omron93/fire-pi/P1200535.JPG

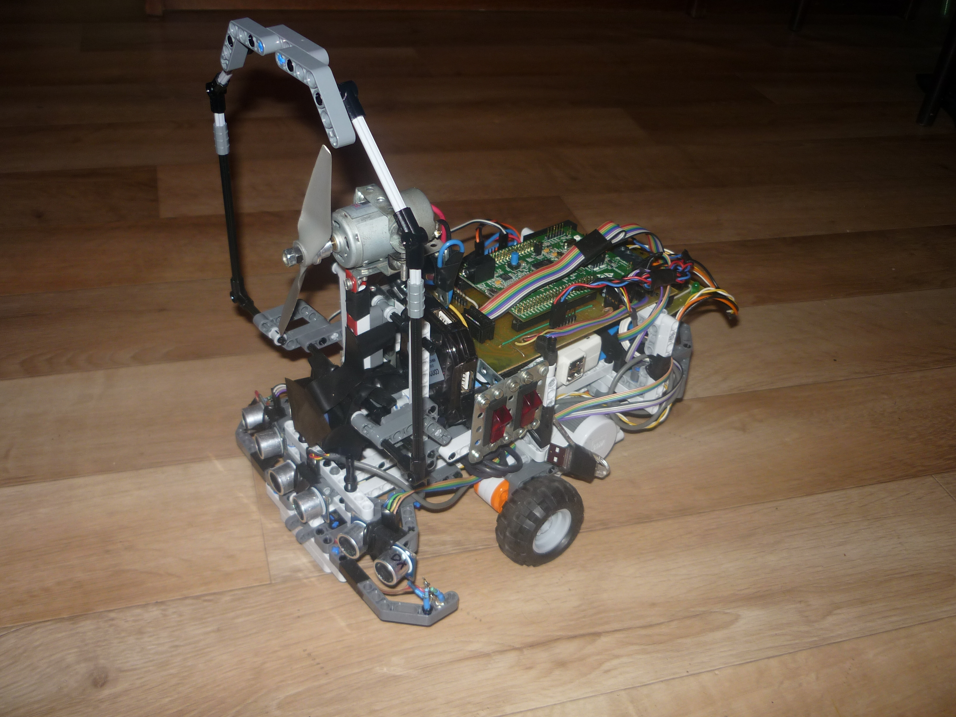
P1200535.JPG
