omron93/fire-pi/DPS/main_board_low.png

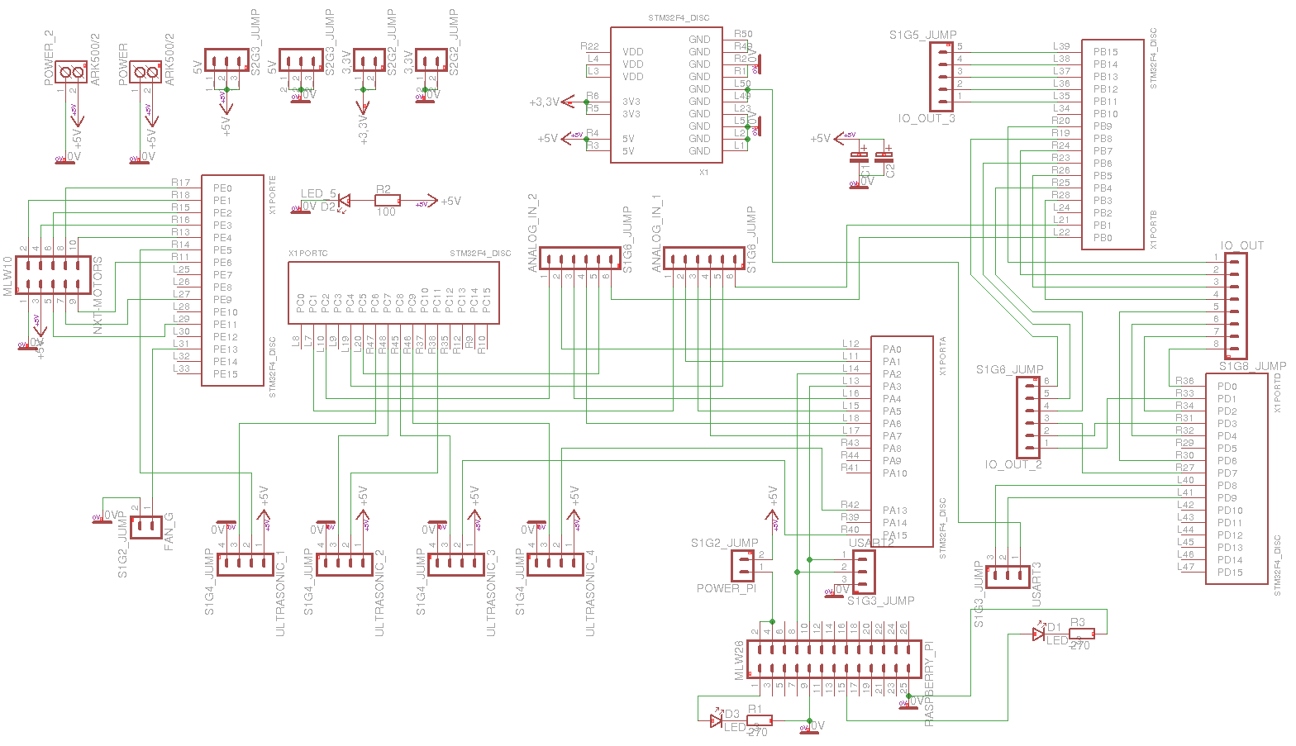
DPS/main_board_low.png
