omron93/fire-pi/DPS/Motor_NXT_Board/1.png

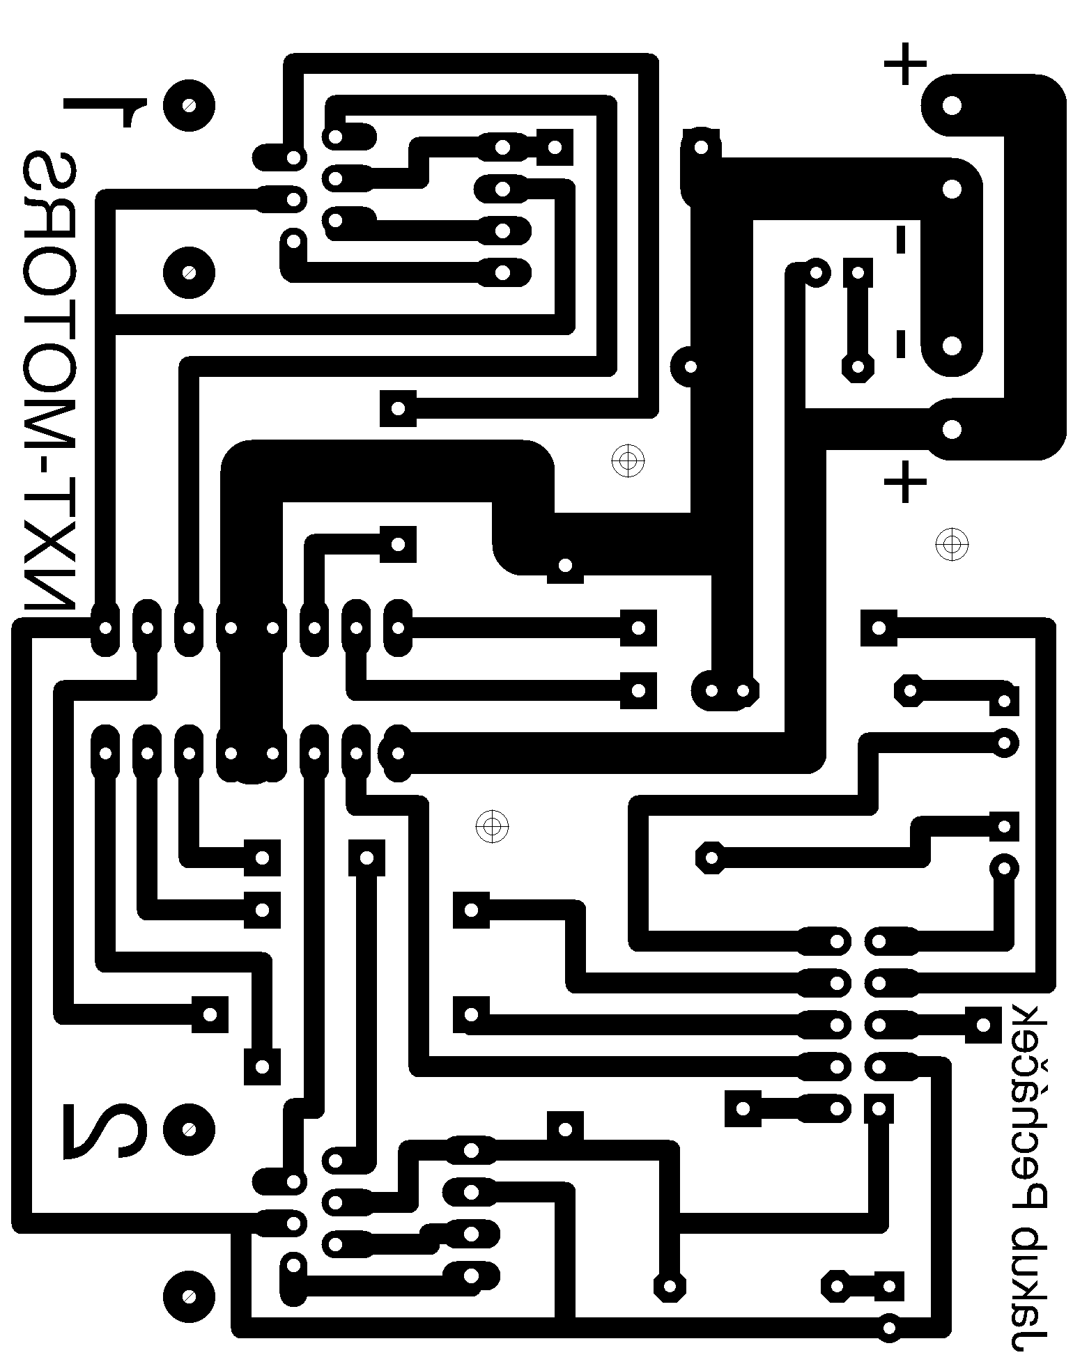
DPS/Motor_NXT_Board/1.png
