omron93/fire-pi/Raspberry_Pi/Candle detector/candle.png

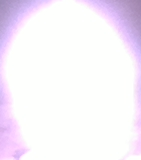
Raspberry_Pi/Candle detector/candle.png
