omron93/fire-pi/DPS/Main_Board/STM.pdf

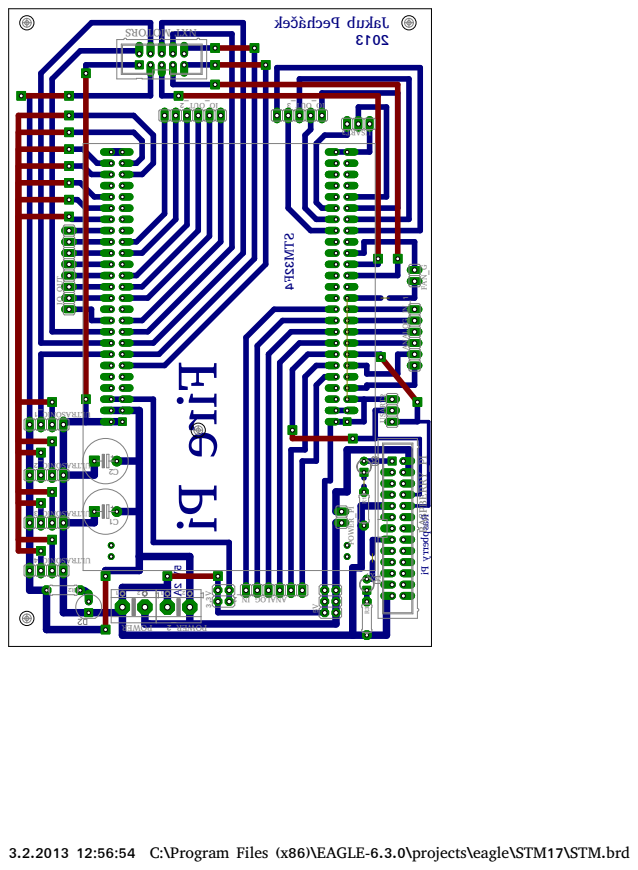
[picture p22: page 1]

3.2.2013 12:56:54 C:\Program Files (x86)\EAGLE-6.3.0\projects\eagle\STM17\STM.brd
