omron93/fire-pi/DPS/Main_Board/STM_brd.pdf

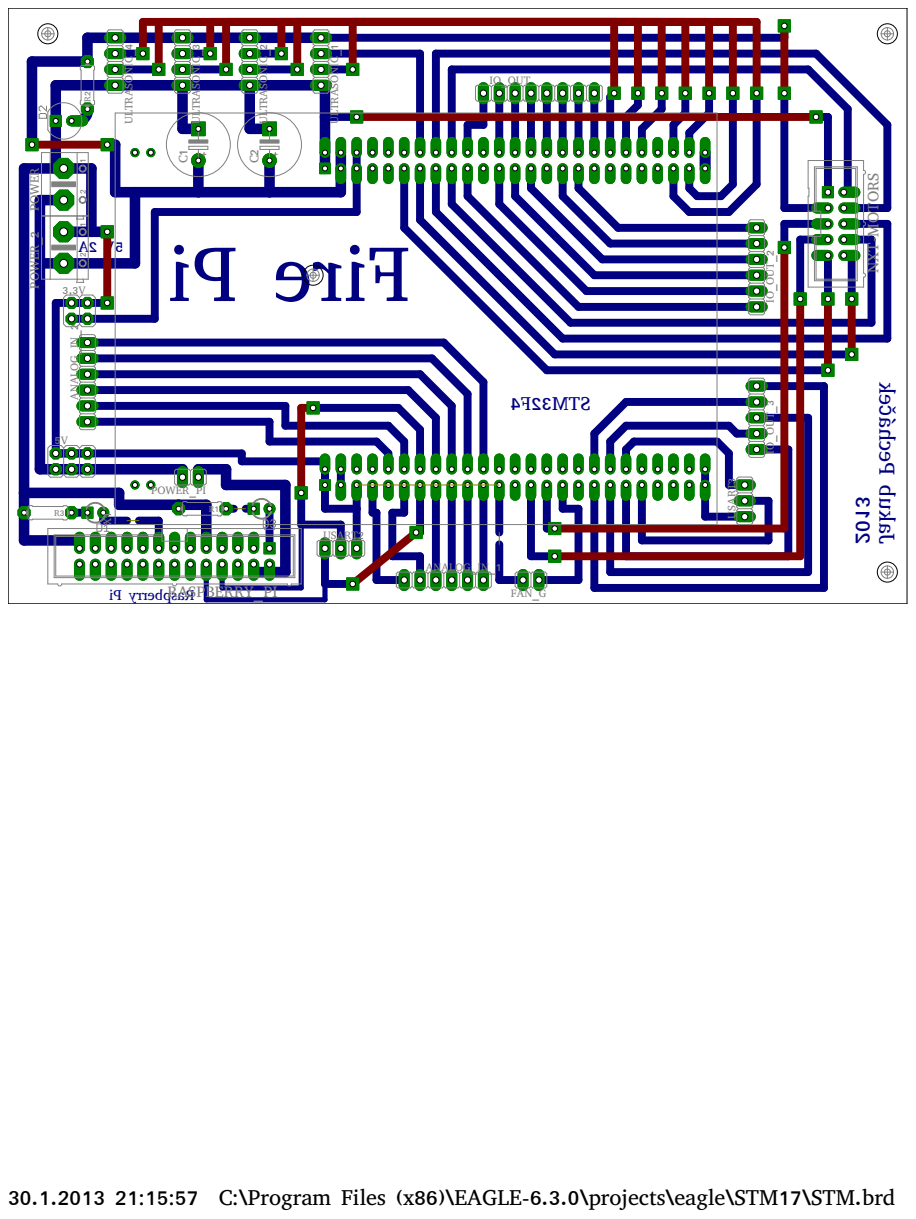
[picture p23: page 1]

30.1.2013 21:15:57 C:\Program Files (x86)\EAGLE-6.3.0\projects\eagle\STM17\STM.brd
