omron93/fire-pi/DPS/Main_Board/STM.brd

## EAGLE design DPS/Main_Board/STM.brd (2014-01-21)

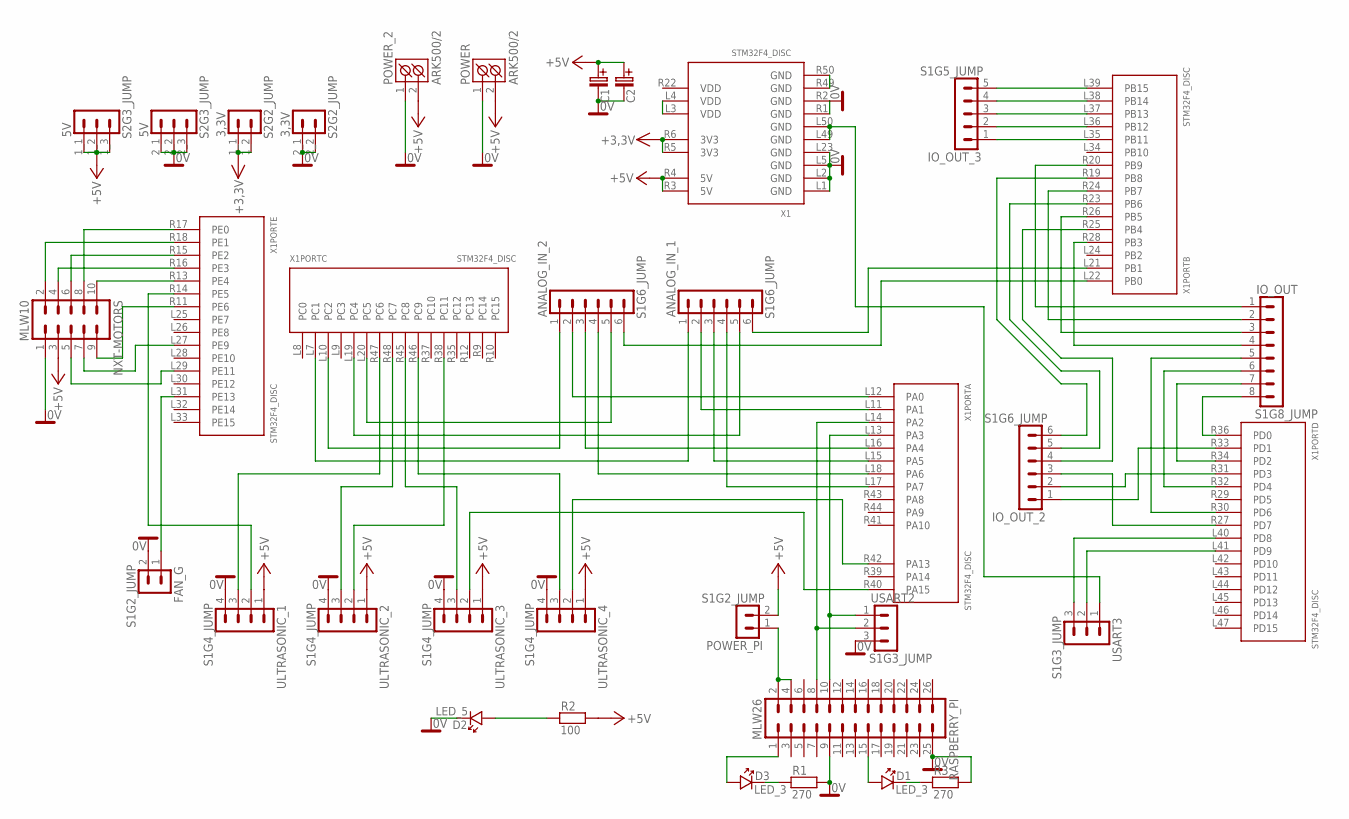
[picture p24: schematic STM.sch]

Parts:
3,3V: S2G2_JUMP; S2G2_JUM
5V: S2G3_JUMP; S2G3_JUM
ANALOG_IN_1, ANALOG_IN_2: S1G6_JUMP; S1G6_JUM
C1, C2: #_RADIAL_POUZDRA5; C_EL_5
D1, D3: LED_3
D2: LED_5
FAN_G: S1G2_JUMP; S1G2_JUM
IO_OUT: S1G8_JUMP; S1G8_JUM
IO_OUT_2: S1G6_JUMP; S1G6_JUM
IO_OUT_3: S1G5_JUMP; S1G5_JUM
NXT-MOTORS: MLW10; MLW10G
POWER: ARK500/2
POWER_2: ARK500/2
POWER_PI: S1G2_JUMP; S1G2_JUM
R1, R3: 270; R_7,5
R2: 100; R_7,5
RASPBERRY_PI: MLW26; MLW26G
ULTRASONIC_1, ULTRASONIC_2, ULTRASONIC_3, ULTRASONIC_4: S1G4_JUMP; S1G4_JUM
USART2, USART3: S1G3_JUMP; S1G3_JUM
X1: STM32F4_DISC

Connections:
0V: 3,3V.2_1 (1), 3,3V.2_2 (2), 5V.2_1 (1), 5V.2_2 (2), 5V.2_3 (3), C1.C- (C_EL-), C2.C- (C_EL-), D2.K, FAN_G.2, NXT-MOTORS.1, POWER.1 (K1), POWER_2.1 (K1), R1.2, R3.2, RASPBERRY_PI.9, RASPBERRY_PI.25, ULTRASONIC_1.4, ULTRASONIC_2.4, ULTRASONIC_3.4, ULTRASONIC_4.4, USART2.3, X1.L1 (GND), X1.L2 (GND), X1.L5 (GND), X1.L23 (GND), X1.R1 (GND), X1.R2 (GND)
+5V: 5V.1_1 (1), 5V.1_2 (2), 5V.1_3 (3), C1.C+ (C_EL+), C2.C+ (C_EL+), NXT-MOTORS.3, POWER.2 (K2), POWER_2.2 (K2), POWER_PI.2, R2.2, ULTRASONIC_1.1, ULTRASONIC_2.1, ULTRASONIC_3.1, ULTRASONIC_4.1, X1.R3 (5V), X1.R4 (5V)
unnamed: ANALOG_IN_1.6, X1.L21 (PB1)
unnamed: NXT-MOTORS.8, X1.R17 (PE0)
unnamed: RASPBERRY_PI.8, USART2.2, X1.L14 (PA2)
unnamed: RASPBERRY_PI.10, USART2.1, X1.L13 (PA3)
unnamed: USART3.2, X1.L41 (PD9)
unnamed: USART3.3, X1.L40 (PD8)
unnamed: NXT-MOTORS.2, X1.R18 (PE1)
unnamed: NXT-MOTORS.6, X1.R15 (PE2)
unnamed: NXT-MOTORS.10, X1.R13 (PE4)
unnamed: NXT-MOTORS.4, X1.R16 (PE3)
unnamed: NXT-MOTORS.5, X1.L29 (PE11)
unnamed: ULTRASONIC_1.2, X1.R14 (PE5)
unnamed: NXT-MOTORS.7, X1.L27 (PE9)
unnamed: NXT-MOTORS.9, X1.R11 (PE6)
unnamed: ULTRASONIC_1.3, X1.R47 (PC6)
unnamed: ULTRASONIC_4.3, X1.R46 (PC9)
unnamed: ULTRASONIC_2.3, X1.R48 (PC7)
unnamed: ULTRASONIC_3.3, X1.R45 (PC8)
unnamed: ANALOG_IN_2.3, X1.L16 (PA4)
unnamed: ANALOG_IN_1.2, X1.L11 (PA1)
unnamed: ANALOG_IN_2.2, X1.L12 (PA0)
unnamed: ANALOG_IN_1.3, X1.L15 (PA5)
unnamed: ANALOG_IN_1.4, X1.L17 (PA7)
unnamed: ANALOG_IN_2.4, X1.L18 (PA6)
unnamed: ANALOG_IN_2.6, X1.L22 (PB0)
unnamed: X1.L3 (VDD), X1.L4 (VDD)
unnamed: FAN_G.1, X1.L31 (PE13)
unnamed: D1.K, R3.1
unnamed: D1.A, RASPBERRY_PI.15
unnamed: D2.A, R2.1
unnamed: IO_OUT.4, X1.R28 (PB3)
unnamed: IO_OUT.3, X1.R26 (PB5)
unnamed: IO_OUT.2, X1.R24 (PB7)
unnamed: IO_OUT_2.3, X1.R27 (PD7)
unnamed: IO_OUT.5, X1.R30 (PD6)
unnamed: IO_OUT.6, X1.R32 (PD4)
unnamed: IO_OUT_2.2, X1.R31 (PD3)
unnamed: IO_OUT.7, X1.R34 (PD2)
unnamed: IO_OUT_2.1, X1.R33 (PD1)
unnamed: IO_OUT.8, X1.R36 (PD0)
unnamed: IO_OUT.1, X1.R20 (PB9)
unnamed: IO_OUT_2.5, X1.R23 (PB6)
unnamed: IO_OUT_3.2, X1.L36 (PB12)
unnamed: D3.K, R1.1
unnamed: IO_OUT_3.4, X1.L38 (PB14)
unnamed: IO_OUT_2.6, X1.R19 (PB8)
unnamed: IO_OUT_2.4, X1.R25 (PB4)
unnamed: IO_OUT_3.1, X1.L35 (PB11)
unnamed: D3.A, RASPBERRY_PI.1
unnamed: IO_OUT_3.3, X1.L37 (PB13)
unnamed: POWER_PI.1, RASPBERRY_PI.2, RASPBERRY_PI.4
unnamed: IO_OUT_3.5, X1.L39 (PB15)
unnamed: USART3.1, X1.L49 (GND), X1.L50 (GND)
unnamed: ANALOG_IN_2.5, X1.L20 (PC5)
unnamed: ANALOG_IN_1.5, X1.L19 (PC4)
unnamed: ANALOG_IN_2.1, X1.L10 (PC2)
unnamed: ANALOG_IN_1.1, X1.L7 (PC1)
unnamed: ULTRASONIC_2.2, X1.R38 (PC11)
unnamed: ULTRASONIC_3.2, X1.R40 (PA15)
unnamed: ULTRASONIC_4.2, X1.R42 (PA13)
unnamed: X1.R49 (GND), X1.R50 (GND)
VCC: 3,3V.1_1 (1), 3,3V.1_2 (2), X1.R5 (3V3), X1.R6 (3V3)
VDD: X1.R22 (VDD)

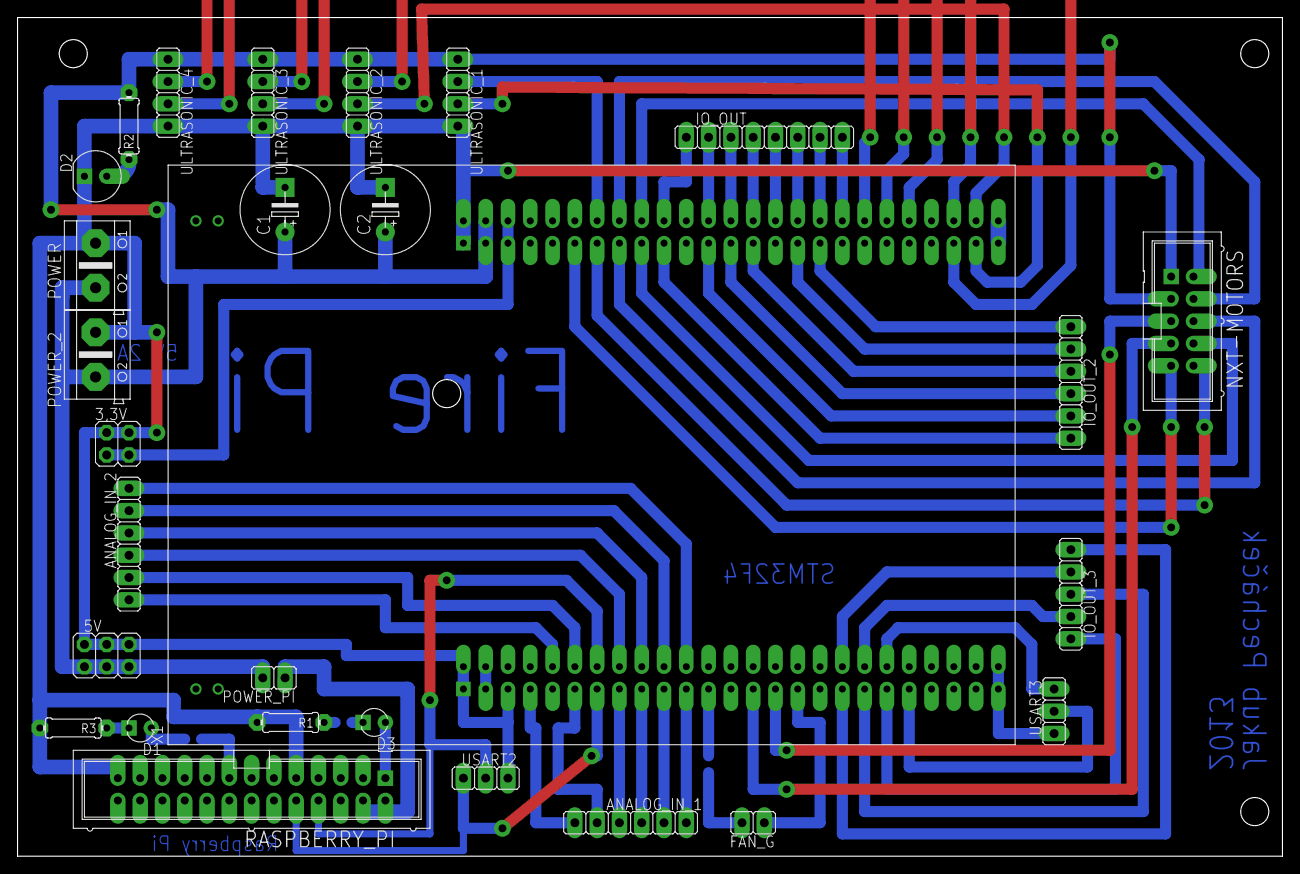
[picture p25: board STM.brd from above]

Board: 2 copper layers, 144.1 x 95.6 mm, 28 parts (0 on the bottom side), 64 nets.
