omron93/fire-pi/DPS/Motor_NXT_Board/NXT.brd

## EAGLE design DPS/Motor_NXT_Board/NXT.brd (2014-01-21)

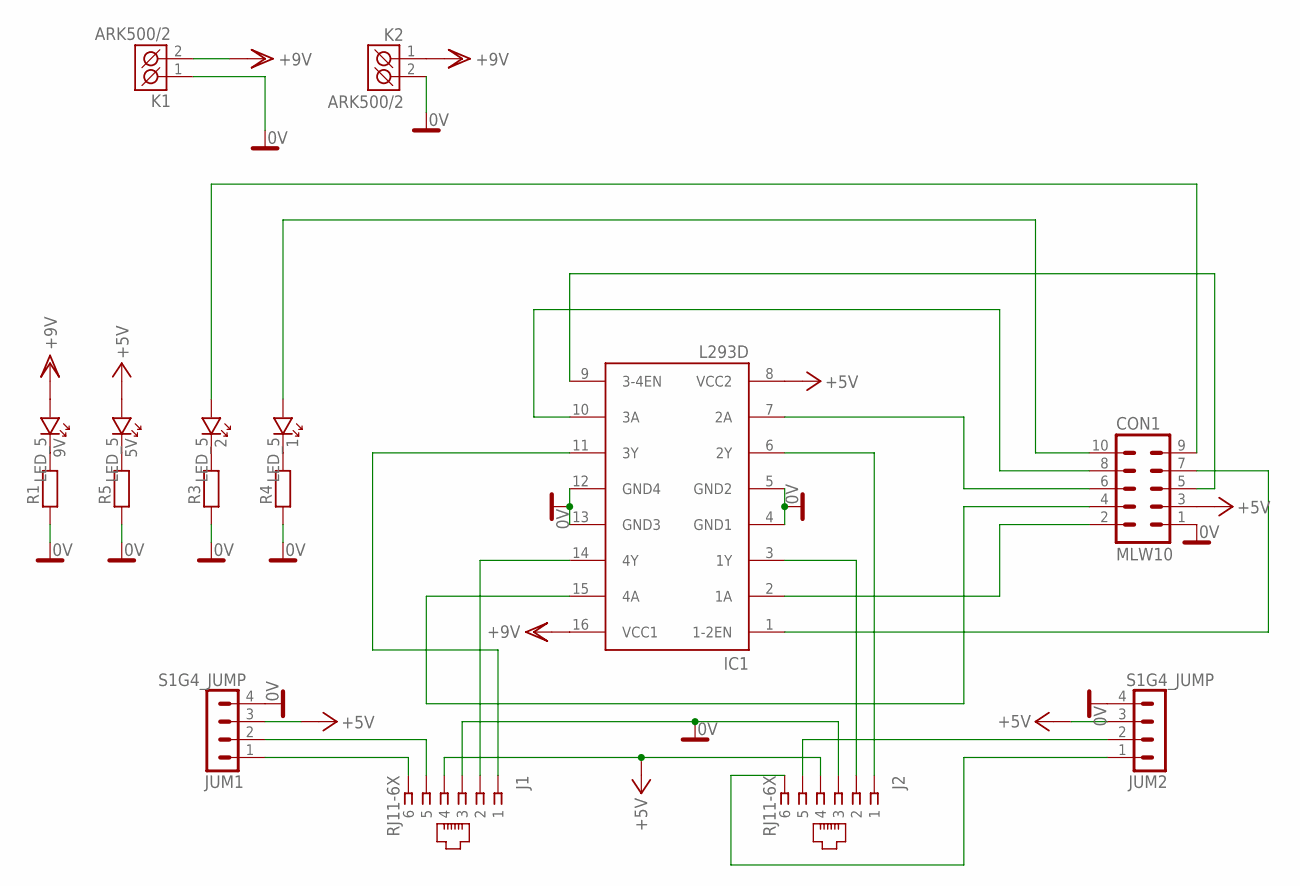
[picture p26: schematic NXT.sch]

Parts:
1, 2, 5V, 9V: LED_5
CON1: MLW10; MLW10G
IC1: L293D; DIL16
J1, J2: RJ11-6X; RJ11-NO_SHIELD
JUM1, JUM2: S1G4_JUMP; S1G4_JUM
K1, K2: ARK500/2
R1, R3, R4, R5: R_10; R-10

Connections:
0V: CON1.1, IC1.4 (GND1), IC1.5 (GND2), IC1.12 (GND4), IC1.13 (GND3), J1.3, J2.3, JUM1.4, JUM2.4, K1.1 (K1), K2.2 (K2), R1.1, R3.1, R4.1, R5.1
+5V: 5V.A, CON1.3, IC1.8 (VCC2), J1.4, J2.4, JUM1.3, JUM2.3
+9V: 9V.A, IC1.16 (VCC1), K1.2 (K2), K2.1 (K1)
unnamed: IC1.11 (3Y), J1.1
unnamed: IC1.14 (4Y), J1.2
unnamed: CON1.6, IC1.7 (2A)
unnamed: CON1.2, IC1.2 (1A)
unnamed: IC1.3 (1Y), J2.2
unnamed: IC1.6 (2Y), J2.1
unnamed: CON1.7, IC1.1 (1-2EN)
unnamed: CON1.5, IC1.9 (3-4EN)
unnamed: CON1.8, IC1.10 (3A)
unnamed: CON1.4, IC1.15 (4A)
unnamed: 1.A, CON1.10
unnamed: 2.A, CON1.9
unnamed: 9V.K, R1.2
unnamed: 5V.K, R5.2
unnamed: 2.K, R3.2
unnamed: 1.K, R4.2
unnamed: J2.5, JUM2.2
unnamed: J2.6, JUM2.1
unnamed: J1.5, JUM1.2
unnamed: J1.6, JUM1.1

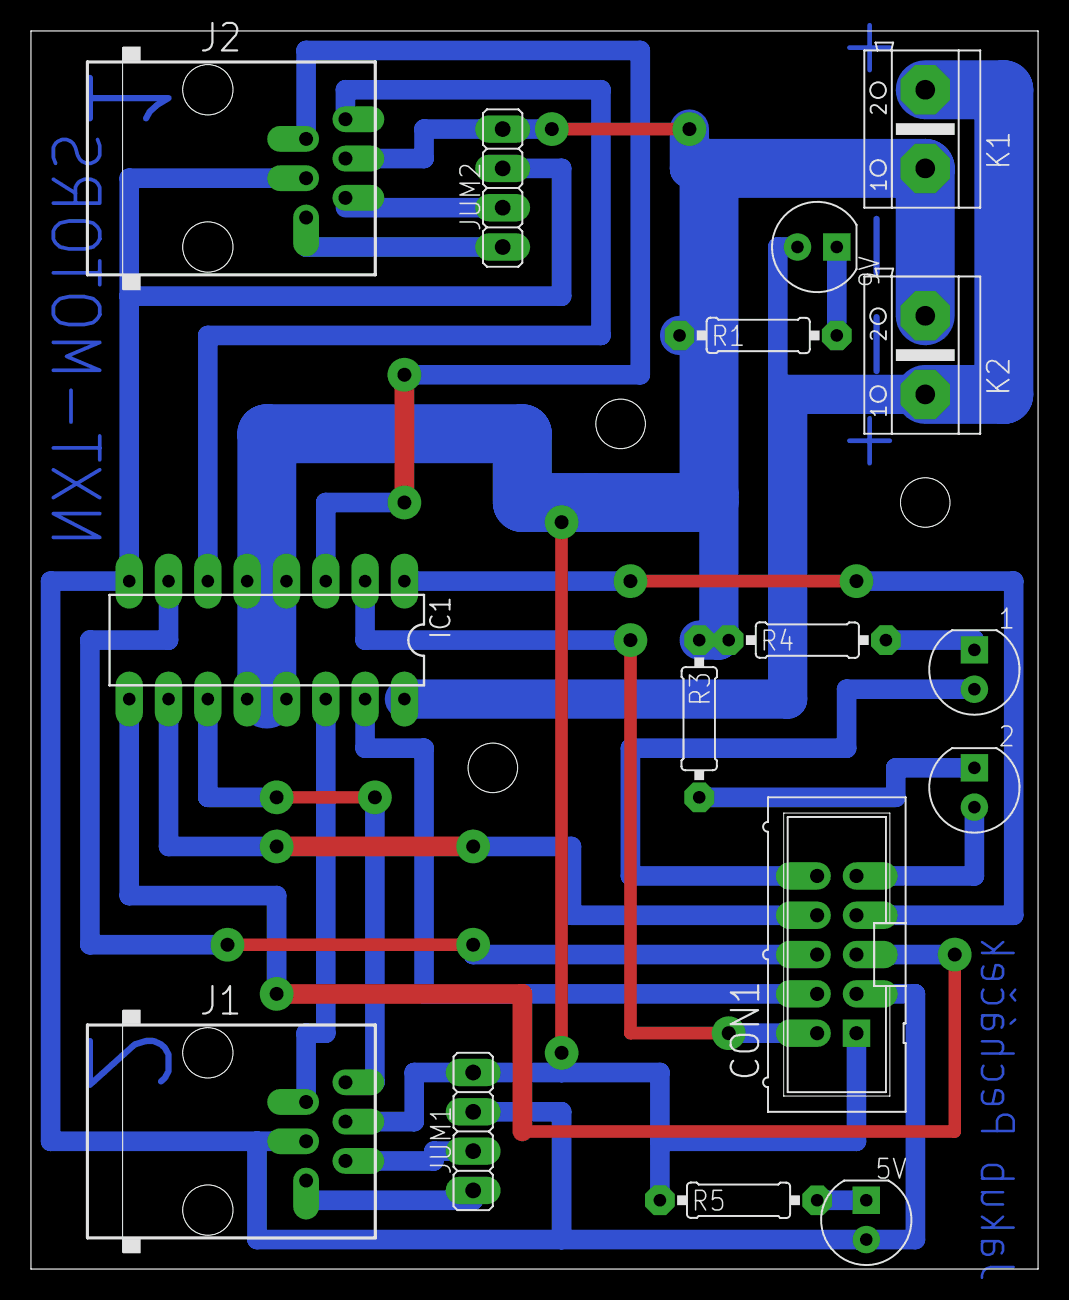
[picture p27: board NXT.brd from above]

Board: 2 copper layers, 65.1 x 80.0 mm, 16 parts (0 on the bottom side), 23 nets.
