omron93/fire-pi/STM32F4-Discovery/programs.h

/* Includes ------------------------------------------------------------------*/
/* Exported types ------------------------------------------------------------*/
/* Exported constants --------------------------------------------------------*/
extern int program;
/* Exported macro ------------------------------------------------------------*/
/* Exported functions ------------------------------------------------------- */
void menu(void);
void candle_sawed(void);
void chaos_simple(void);
void loop_wall(void);
void homologation(void);
void stop_on_line(void);
void follow_line(void);
void go_to_center(void);
void chaos(void);
void wall_detect(void);
