omron93/fire-pi/STM32F4-Discovery/candle_position.c

/* Includes ------------------------------------------------------------------*/
#include "candle_position.h"
#include "usart.h"
#include <misc.h>	
#include <stm32f4xx.h>
#include <stm32f4_discovery.h>
#include <stdio.h>
/* Private typedef -----------------------------------------------------------*/
/* Private define ------------------------------------------------------------*/
/* Private macro -------------------------------------------------------------*/
/* Private variables ---------------------------------------------------------*/
char a[50];
int candle_pos;
int candle_saw=0;
/* Private function prototypes -----------------------------------------------*/
/* Private functions ---------------------------------------------------------*/
void candle_position(int x, int z)
{
	candle_pos = x;
	
if(x > RIGHT_CANDLE)
	{
		USART_puts(USART2, "right");
		STM_EVAL_LEDOn(LED4);	
		STM_EVAL_LEDOff(LED5);
	}
	else if(x < LEFT_CANDLE)
	{
		USART_puts(USART2, "left");
		STM_EVAL_LEDOn(LED5);
		STM_EVAL_LEDOff(LED4);
	}
	else 
	{
		USART_puts(USART2, "center");
		STM_EVAL_LEDOff(LED5);
		STM_EVAL_LEDOff(LED4);
	}
/*
	USART_puts(USART2, " >> rx: ");
	sprintf(a, "%d", x);
	USART_puts(USART2,  a);
	USART_puts(USART2, " - ");
	sprintf(a, "%d", z);
	USART_puts(USART2,  a);
	USART_puts(USART2, " \n");
	*/
}
