omron93/fire-pi/STM32F4-Discovery/pwm.h

/* Includes ------------------------------------------------------------------*/
#include "stm32f4_discovery.h"

/* Exported types ------------------------------------------------------------*/
/* Exported constants --------------------------------------------------------*/
/* Exported macro ------------------------------------------------------------*/
/* Exported functions ------------------------------------------------------- */
void PWM_SetDC(uint16_t channel,uint16_t dutycycle);
void blow(void);
void blow_demo(void);
/* Exported variables ------------------------------------------------------- */
