omron93/fire-pi/STM32F4-Discovery/usart.c

/* Includes ------------------------------------------------------------------*/
#include "usart.h"
#include <misc.h>
#include <stm32f4xx.h>
#include <stm32f4xx_usart.h>
#include <string.h>
#include <stdio.h>

/* Private typedef -----------------------------------------------------------*/
/* Private define ------------------------------------------------------------*/
/* Private macro -------------------------------------------------------------*/
/* Private variables ---------------------------------------------------------*/
/* Private function prototypes -----------------------------------------------*/
/* Private functions ---------------------------------------------------------*/
void USART_puts(USART_TypeDef* USARTx, volatile char *s){

	while(*s){
		// wait until data register is empty
		while( !(USARTx->SR & 0x00000040) ); 
		USART_SendData(USARTx, *s);
		*s++;
	}
}
