omron93/fire-pi/(commit log)

2013-03-07 Raspberry Pi - Soft
2013-03-11 ADC funguje
2013-03-13 ADC + IR -> OK
2013-03-15 raspi - gui switch
2014-01-21 DPS + Documentation added
    [NXT.brd, NXT.sch, STM.brd, STM.sch]
