omron93/fire-pi/(notices)

Notices in the files:
Raspberry_Pi/Candle detector/main.cpp:
This program is free software; you can redistribute it and/or modify
it under the terms of the GNU General Public License as published by
the Free Software Foundation; either version 2 of the License, or
(at your option) any later version.
parts and their libraries:
Copyright (C) PaJa 2011
Copyright (C) PaJa 2001-2011
Copyright (C) PaJa 2003-2009
